fakhrullhafiz/ars_project/(commit log)

2026-06-30 Add Week 1 starter scaffolding: motor control, encoder test, main_robot integration, obstacle_avoidance ROS2 package
2026-07-01 Confirm 2S battery, bump MAX_PWM to 180, document bring-up progress
    Motor pin wiring moved to the combined IN-pin analogWrite scheme
    (D2-D9, no separate PWM pins) and MAX_PWM raised from 120 to 180
    now that the battery is confirmed 2S (8.4V max, 6.0/8.4 ~= 71%
    duty). Front-left motor (D2/D3) is hardware-validated: correct
    forward/reverse direction, thermal-checked at MAX_PWM=180.
    CLAUDE.md updated with team/scope, confirmed hardware facts,
    architecture and command references, and current bring-up status
    (FL confirmed, FR wired, rear pair blocked on a driver-2 splitter).
    Claude-Session: https://claude.ai/code/session_01TAZRF7ytW5XN6De7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
    [main_robot.ino, motor_control.ino]
2026-07-02 Add slow single-motor ID test mode to motor_control.ino
    Bring-up aid: keys 1-8 drive one motor at a time (FL/FR/RL/RR, fwd/rev)
    at TEST_PWM=90 so the shaft turns slowly enough to read a sticky-note flag
    and confirm corner + direction. Existing wasdqex driving behavior unchanged;
    TEST_PWM stays well under MAX_PWM and is diagnostic-only.
2026-07-02 Document high-current lever-nut power distribution in CLAUDE.md
    Records the actual battery power architecture: XT60 -> 2-in/4-out lever-nut
    distribution block (blue=+, orange=-), Channel 1 -> driver 1 (front), Channel 2
    -> driver 2 (rear), with the SZDULI 19V/SBC converter tapped off one output line.
    Also resolves the now-stale "rear pair blocked / no breadboard splitter" status
    note (all 4 motors now spin; power fan-out is solved) and records that spin
    direction is still unverified pending the mechanical shaft-to-wheel coupling fix.
    Adds code/troubleshooting implications: separate logic vs motor-power domains,
    Mega GND -> battery-negative common ground, and shared-input-rail current budge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
2026-07-02 Add arduino/WIRING.md bench wiring reference
    Self-contained bench reference for motion-control wiring: canonical pin map
    (FL/FR/RL/RR -> D2-D9 + OUT terminals), wiring plan grouped by electrical
    domain with status, suggested arrange order, and clean-wiring tips. Pulls the
    power-distribution and safety reasoning together from CLAUDE.md into one place
    to reference at the workbench.
2026-07-16 Finalize 4-encoder pin plan: all corners fit on D18-D21
    Only phase A needs a true hardware-interrupt pin (attachInterrupt); phase
    B is read with plain digitalRead() inside the ISR, so it can go on any
    free digital pin. That means the Mega's 4 remaining interrupt pins
    (D18-D21, since D2/D3 are taken by the FL motor) cover all 4 corners'
    phase-A signals, not just 2 -- corrects an earlier assumption in
    CLAUDE.md/WIRING.md that both channels needed interrupt pins.
    Pin plan: FL A=D18/B=D22, FR A=D19/B=D23, RL A=D20/B=D24, RR A=D21/B=D25.
    Moves FL's phase B off D19 (now free for FR's phase A) onto D22.
    encoder_test.ino and main_robot.ino still only wire/read FL -- reading
    all 4 simultaneously ne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
    [encoder_test.ino, main_robot.ino]
2026-07-16 Fix encoder_test.ino pin conflict and support all 4 wheels after full rewire
    The team re-wired all 4 motors and all 4 encoders from scratch on
    breadboard (logic-side fan-out only; battery power stays on soldered
    splices, not breadboard). encoder_test.ino still hardcoded D2/D4 for
    its single front-left example, which now collides with the FL/FR
    motor IN pins. Rewrote it to read all 4 encoders: FL/FR keep hardware
    interrupts (D18/19, D20/21), RL/RR use the Mega's PCINT0 group
    (D11/24, D12/25) via raw AVR registers since only 6 Mega pins support
    true hardware interrupts and D2/D3 are already taken by the FL motor.
    Also updated CLAUDE.md's Current status and Architecture sections to
    reflect the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
    [encoder_test.ino]
2026-07-16 Temporarily lower MAX_PWM to 80 for wheel-direction visual check
    Slowed down motor_control.ino so gear/wheel rotation could be watched
    by eye and cross-checked against the commanded direction for each of
    w/a/s/d/q/e. Lower duty cycle is strictly safer than 180, not riskier.
    Flagged in-code as temporary -- revert to 180 before real driving or
    thermal testing once direction is confirmed on the ground.
    [motor_control.ino]
2026-07-17 Confirm all 4 encoders reading correctly, document sign convention
    RR initially read nothing — phase-A lead was physically on D10 instead
    of D12, fixed by reseating. FL/RL reading opposite sign from FR/RR on
    forward rotation is expected (mirrored motor mounting on a mecanum
    chassis), not a wiring fault — noted so future distance/direction code
    applies a per-side sign correction instead of "fixing" it.
2026-07-17 Revert MAX_PWM 80->180 in motor_control.ino after direction check passes
    All 4 motors confirmed correct spin direction on hardware (2026-07-17):
    single-motor ID test (1-8) and combined forward/reverse/strafe/rotate
    (w/s/a/d/q/e) all matched expected rotation, no wiring swaps needed.
    main_robot.ino's MAX_PWM was never lowered (stayed at 180 throughout),
    so only motor_control.ino needed the revert. Thermal check at 180 is
    still outstanding per CLAUDE.md.
    [motor_control.ino]
2026-07-17 Record thermal check pass for all 4 motors at MAX_PWM=180
    Ran forward/reverse/strafe/rotate under real load (on the ground, not
    free-spinning) in short bursts, checking motor casings and driver
    boards between bursts. All stayed comfortably warm across several
    cumulative minutes -- no code change needed, MAX_PWM=180 already
    confirmed safe to keep.
2026-07-17 Calibrate COUNTS_PER_CM from measured FL encoder counts
    Front-left wheel: 70 counts per hand-rotated revolution (encoder_test.ino),
    97mm wheel diameter -> COUNTS_PER_CM = 70 / (pi*97mm/10) =~ 2.297.
    Replaces the old placeholder (20.0), which would have made every
    "drive N cm" distance wildly wrong. Based on a single manual-rotation
    trial; worth a repeat measurement later to confirm before trusting it
    for precise distances.
    [main_robot.ino]
2026-07-17 Temporarily lower main_robot.ino MAX_PWM to 100 for COUNTS_PER_CM sanity check
    The sketch has no braking -- it just cuts power once the target encoder
    count is reached and coasts to a stop. At full 180 that coasting
    overshoot would mix with genuine calibration error, making the F100
    sanity-check result hard to interpret. Running slower isolates the
    calibration error. Revert to 180 once the sanity check confirms
    COUNTS_PER_CM.
    [main_robot.ino]
2026-07-17 Restore main_robot.ino MAX_PWM to 180 after COUNTS_PER_CM sanity check passes
    F100 test (100cm commanded) landed close to the 100cm mark at the
    temporarily-lowered MAX_PWM=100, confirming COUNTS_PER_CM=2.297 is
    good enough to trust. Restoring the normal 180 ceiling now that the
    check is done.
2026-07-17 Extend main_robot.ino to track all 4 wheel encoders
    Ports encoder_test.ino's proven FR (hardware interrupt) and RL/RR
    (PCINT0 pin-change interrupt) wiring into main_robot.ino, alongside
    the existing FL tracking (renamed encoderCount -> flCount for naming
    consistency with the other 3).
    Scope is intentionally limited to tracking + diagnostics: the F<cm>
    stop condition still uses flCount alone, exactly as before -- that's
    the logic already validated by the F100 sanity check, and
    COUNTS_PER_CM was only ever calibrated against FL. frCount/rlCount/
    rrCount are printed after each drive so a per-wheel rotation mismatch
    is visible, but folding them into the actual stop/steering decision is
    a separat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
2026-07-17 Update WIRING.md: motor direction verification is resolved, not blocked
    Stale note said direction verification was blocked on a mechanical
    shaft-to-wheel coupling fix. That's no longer accurate -- all 4 wheels
    were confirmed correct (forward/reverse/strafe/rotate) with no OUT
    lead swaps needed, per CLAUDE.md's Current status section.
2026-07-19 Fill in Week 1-3 status and add next-session checklist
    Backfilled Week 1/2 from actual commit history (Week 2 had no repo
    activity), and added Week 3 covering the Layer 0-1 hardware validation
    plus the pending LIDAR/RealSense blocker. NEXT_SESSION.md holds the
    step-by-step plan for the next lab session so it doesn't clutter README.
2026-07-19 Explain why the Axiomtek SBC CPU-variant question matters
    Ports the useful content from stale PR #6 (branch
    worktree-claude-md-sbc-cpu-note) onto current main; that branch predated
    today's README/NEXT_SESSION.md updates so merging it directly would have
    reverted them.
2026-07-21 Add vendored ydlidar_ros2_driver; correct RPLIDAR->YDLidar throughout
    Physical LIDAR was confirmed to be a YDLidar, not the RPLIDAR A1 this
    repo assumed until now. Ports just the vendored driver package from
    Tsaqif's person-c-perception branch onto a clean base (current main),
    since that branch also carried unrelated reversions of main_robot.ino/
    motor_control.ino, a deleted NEXT_SESSION.md, and a deleted
    obstacle_avoidance package -- all from a stale, un-synced local copy on
    the SBC, not intentional changes. person-c-perception is left untouched
    on origin pending a conversation with Tsaqif about which SBC directory
    should be treated as the real clone going forward.
    obstacle_avoidance did n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
    [obstacle_detector_node.py]
2026-07-21 Document SBC USB/power finding and resolve RealSense-code question
    RealSense: confirmed no application code exists yet on the SBC, only
    SDK + viewer config -- nothing was lost, this work just hasn't started.
    USB: all 3 sensors were found sharing one external hub, D455 running
    at USB2 speeds and the hub's combined draw over a typical 500mA budget.
    Physical fix (move D455 to the SBC's free USB3 port) in progress.
    Also resolves the earlier open question about which SBC directory is
    canonical: ~/ars_project, confirmed, no duplicate clone exists.
2026-07-21 Document LIDAR+RealSense USB brownout findings; add RealSense rviz config
    LIDAR is confirmed reliable alone (a stuck unit needs a full power-cycle,
    not just a cable reseat). RealSense's video streams are corrupted on
    every hub/port/resolution combination tested tonight, including the
    hub's lowest supported profiles, and the SBC's real USB3 controller
    (Bus 004) remains unused - this points to a hardware/USB problem, not
    code or params, so future sessions shouldn't spend time re-tuning
    depth/color profiles for it.
    Adds ros2_workspace/rviz/realsense_view.rviz (color/depth image +
    pointcloud displays) so RealSense can be viewed without recreating the
    config each time.
2026-07-22 Fix ttyUSB port-mismatch bug; document Arduino reset risk and full stack success
    ydlidar.yaml hardcoded port: /dev/ttyUSB0, but that number is assigned by
    enumeration order, not device identity - after enough reconnects the
    Arduino ended up on ttyUSB0 instead of the LIDAR, so the driver was
    silently talking to the wrong serial port. Fixed with a udev rule
    (/etc/udev/rules.d/99-ydlidar.rules) matching the CP210x's fixed
    vendor:product ID, giving a stable /dev/ydlidar symlink regardless of
    enumeration order.
    Also documents two more findings from tonight: a shared-hub power dip
    can brown out and reset the Arduino mid-motion (not just glitch
    sensors), and a breakthrough where separating the LID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
2026-07-22 Confirm Arduino+RealSense+LIDAR combo reliable via actual ROS2 pipeline
    Retested the physical-separation workaround (LIDAR on its own direct
    SBC port, away from RealSense/Arduino on the external hub) a second
    time, this time running the actual ros2 launch realsense2_camera node
    instead of just realsense-viewer. Zero frame corruption and zero USB
    re-enumerations over 35+ seconds alongside a steady /scan - confident
    enough now to mark this resolved rather than a one-off.
2026-07-22 Add combined LIDAR+RealSense rviz view; document unmeasured placeholder TF
    combined_view.rviz shows LaserScan, ColorImage, DepthImage, and
    PointCloud together in one window - useful for a quick simultaneous
    sanity check of both sensors. Requires Reliability Policy: Best Effort
    on the LaserScan topic explicitly, since RViz's default QoS otherwise
    silently mismatches the driver's and receives nothing.
    CLAUDE.md documents that the LIDAR and camera have no real relative
    positioning yet (no URDF, base_link isn't tied to a measured chassis
    point) - a guessed placeholder static transform was used by hand to
    get both rendering together visually, explicitly flagged as not
    measured data so nobody mis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
2026-07-22 Confirm main+RealSense/LIDAR merge; document via CLAUDE.md
    perception-ydlidar merged into main (authorized by Pekol) - this also
    caught main up on ~18 previously-unmerged commits of encoder/motor
    work that had been sitting on feature branches. No arduino/ files
    touched by the merge itself.
2026-07-22 Add manual teleop + encoder telemetry; raise MAX_PWM to 255
    - main_robot.ino: w/a/s/d/q/e/x teleop for SLAM/odometry bring-up driving,
    and a periodic "E,<fl>,<fr>,<rl>,<rr>,<millis>" telemetry line consumed
    by the new wheel_odometry ROS2 package.
    - Both sketches: MAX_PWM 180 -> 255, explicit user-acknowledged tradeoff
    after full chassis assembly weight caused bogging at 180. Removes the
    prior 6.0V motor-rating safety margin against the 8.4V pack -- watch
    motor temperature. See CLAUDE.md Critical Hardware Facts for full
    reasoning.
2026-07-22 Add RealSense depth as a second obstacle-avoidance source
    obstacle_detector_node now subscribes to /camera_scan (RealSense depth via
    depthimage_to_laserscan) in addition to /scan (LIDAR) -- either source
    inside STOP_DISTANCE_M triggers a stop (OR, not AND), both sharing the
    node's one serial connection to the Arduino. New
    obstacle_avoidance_with_camera_launch.py brings up the camera + converter
    + detector chain; obstacle_avoidance_launch.py (LIDAR-only) is unchanged.
    [obstacle_detector_node.py]
2026-07-22 Add odometry and SLAM packages: wheel_odometry, cartographer_slam, lidar_odometry, mecanum_sim
    - wheel_odometry: encoder-based /odom + TF from main_robot.ino's telemetry.
    Superseded the same day by the chassis-crack finding (untrustworthy
    wheel odometry) -- kept for teleop/diagnostics, not the motion source
    used going forward.
    - cartographer_slam: odometry-free LIDAR-only SLAM via Cartographer
    (use_odometry=false). Confirmed working live on hardware -- this is the
    current SLAM method.
    - lidar_odometry: ICP scan-matching odometry (RTAB-Map icp_odometry) as an
    alternative LIDAR-only odometry source. PARKED -- weak match ratio on
    real-room testing, not pursued further given eval t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
    [mecanum_drive_controller.yaml, mecanum_robot.urdf.xacro, mecanum_test_room.sdf]
2026-07-22 Add ars_description: live URDF, camera+SLAM combined launch, confirmed on hardware
    Display-only URDF (chassis + 4 wheels + LIDAR mount) with wheels driven
    live in RViz from the Arduino's encoder telemetry via
    encoder_joint_state_node. Three launch tiers:
    - display_launch.py: robot model only
    - robot_and_lidar_launch.py / robot_and_slam_launch.py: + LIDAR, + SLAM
    - robot_slam_camera_launch.py: full stack (robot + encoders + LIDAR +
    Cartographer SLAM + RealSense), including a DepthCloud display so the
    depth stream renders as colored 3D points in the map alongside the
    LIDAR scan.
    RealSense is brought up depth-first, RGB enabled ~2s later via a runtime
    param set, Motion Module (accel/gyro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
    [ars_robot.urdf.xacro]
2026-07-22 Document full stack success: URDF+encoders+LIDAR+RealSense+SLAM confirmed on hardware
    Update Current Status/Architecture/Known Open Questions to reflect the
    ars_description package completion, the new SLAM/odometry packages
    (cartographer_slam confirmed as the working method, wheel_odometry and
    lidar_odometry parked), and the combined robot_slam_camera_launch.py run
    confirmed working end-to-end on the SBC -- LIDAR scan and RealSense depth
    point cloud both render correctly and match each other geometrically.
2026-07-22 Fix Cartographer runaway-pose divergence in odometry-free LIDAR SLAM
    Narrow the real-time correlative scan matcher's search window from 45deg/0.2m
    to 30deg/0.15m. The 45deg widening (added 2026-07-22 to fix hand-rotation
    tracking loss) let the matcher alias onto wrong-but-higher-scoring offsets in
    long/feature-poor scans; with no odometry or IMU to catch it, the constant-
    velocity extrapolator compounded each bad match into a runaway pose (observed
    map coordinates in the hundreds of metres while physically stationary). 30deg
    still tracks ~97 deg/s of rotation at this LIDAR's ~3.25Hz scan rate, above
    hand-turning speed, so the 2026-07-22 fix should hold. Confirmed on hardware:
    map stayed room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
2026-07-22 Add teleop_bridge node + camera/SLAM teleop launch for driven mapping
    teleop_bridge_node owns the Arduino serial port for BOTH encoder telemetry
    (-> /joint_states) and keyboard drive commands (w/a/s/d/q/e/x, space=E-stop,
    g=clear), from one process -- avoids the dual-serial-open that
    encoder_joint_state_node's docstring warns against when you need to drive
    while everything else is up. Reads keystrokes in cbreak mode, so it must run
    as its own `ros2 run` in a dedicated terminal, not inside a launch file.
    robot_slam_camera_teleop_launch.py is the full stack (robot + LIDAR +
    Cartographer + RealSense staggered depth/RGB + DepthCloud + RViz) MINUS
    encoder_joint_state_node, since teleop_bridge ta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
    [teleop_bridge_node.py]
2026-07-22 Add directional LIDAR obstacle guard to teleop_bridge
    While driving via teleop, split /scan into four 90-degree sectors
    (front/back/left/right, 0 rad = robot forward per the URDF) and refuse to
    forward a drive key that would translate INTO a sector with an obstacle
    within stop_distance_m (default 0.30 m). An obstacle in front blocks 'w'
    only; s/a/d/q/e still work -- the point is to stop moving toward the
    obstacle while keeping every other escape route open. Rotation (q/e) and
    stop (x/space/g) are never gated. If the robot is already driving into a
    direction that becomes blocked, an 'x' stop is sent automatically (teleop
    drives continuously, so filtering keypresses alone wouldn't halt motion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
2026-07-22 Add camera+LIDAR sensors demo launch (no SLAM, no driving)
    camera_lidar_view_launch.py + camera_lidar_view.rviz: a light "look at our
    sensors" demo showing the RealSense depth/RGB/DepthCloud alongside the
    YDLidar scan in one RViz window (Fixed Frame = base_link). Same staggered
    camera start and placeholder base_link->camera_link transform as the mapping
    launch, but no Cartographer and no serial port opened, so it comes up fast
    with nothing to steer. Complements robot_slam_camera_teleop_launch.py (the
    mapping demo).
2026-07-22 Add log_sectors debug readout to teleop_bridge's obstacle guard
    Optional throttled (~1/s) log of the nearest distance per sector plus which
    directions are currently blocked -- ros2 run ... -p log_sectors:=true. Off
    by default so normal runs stay quiet. Added to verify the guard on real
    hardware tonight: confirmed all four directions (front/back/left/right)
    correctly detect an obstacle at ~20-27cm and block the matching drive key
    while leaving the others free, with the LIDAR + teleop_bridge running
    standalone (no SLAM/camera). CONFIRMED WORKING ON HARDWARE.
    [teleop_bridge_node.py]
2026-07-22 Add combined robot model + camera + LIDAR view (no SLAM, no driving)
    New demo launch: robot_state_publisher + encoder_joint_state_node (live
    wheel TF axes from encoder telemetry) + YDLidar + RealSense depth-then-RGB
    staggered start (Motion Module permanently off, per the confirmed "only 2
    of 3 modules at once" hardware limit) + one RViz window (RobotModel, TF
    with axes, LaserScan, Color/Depth images, DepthCloud; Fixed Frame =
    base_link). Fills the gap between camera_lidar_view_launch.py (sensors
    only, no robot model) and robot_slam_camera_teleop_launch.py (same sensors
    + robot model, but also drags in Cartographer SLAM and expects
    teleop_bridge running separately) -- this one is just "the ro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
